BudhvinHewage/RC-Car/Electrical Wiring Diagram.png

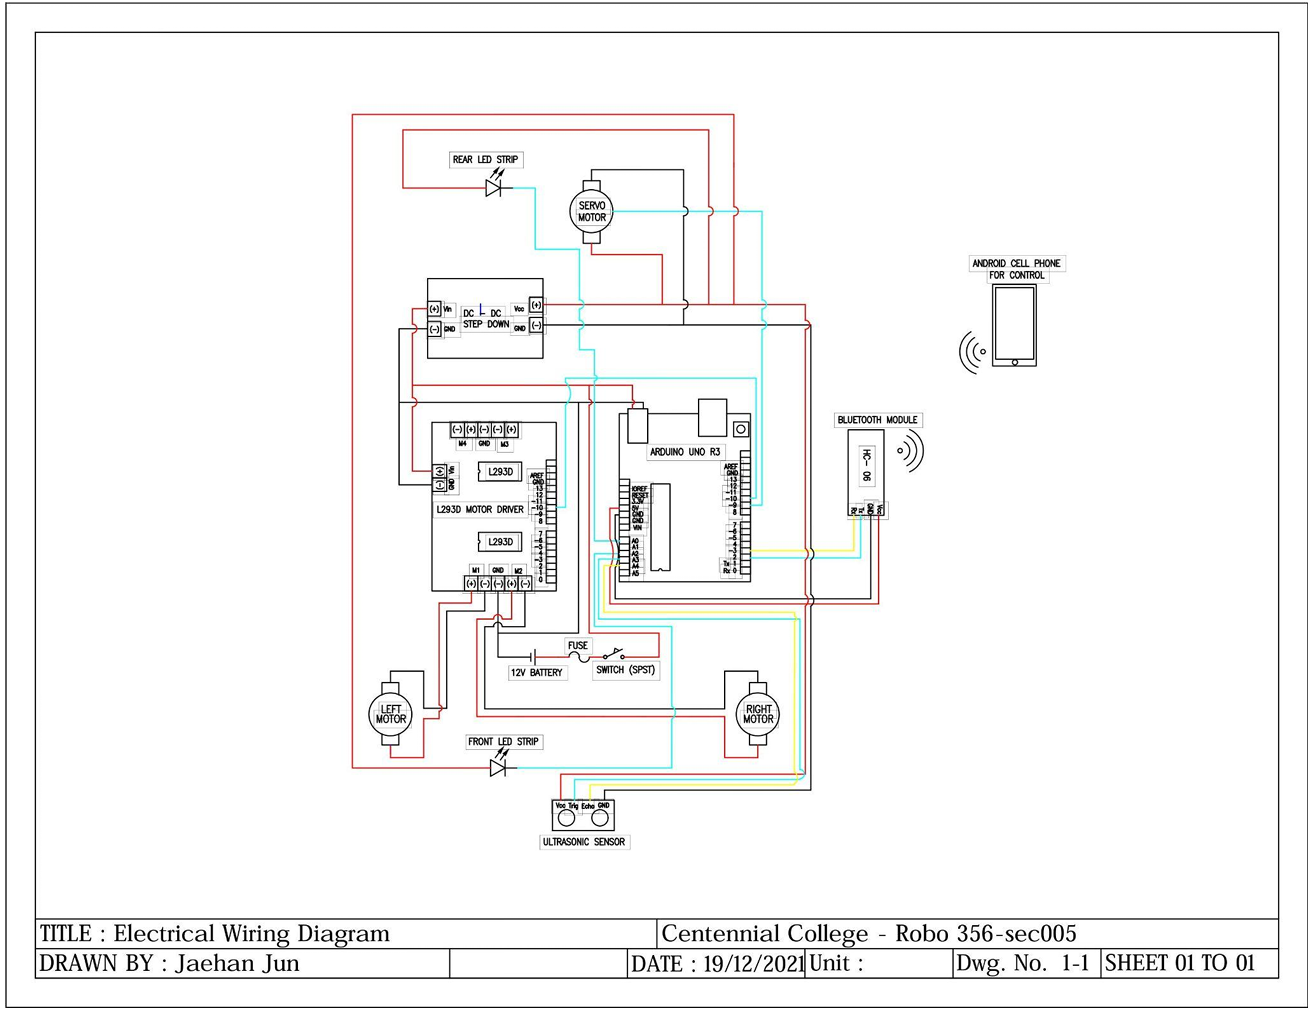
Electrical Wiring Diagram.png
